jmnich/beam_kit_1/beam_kit_1.kicad_pcb

## KiCad design beam_kit_1.kicad_pcb (2026-11-06)

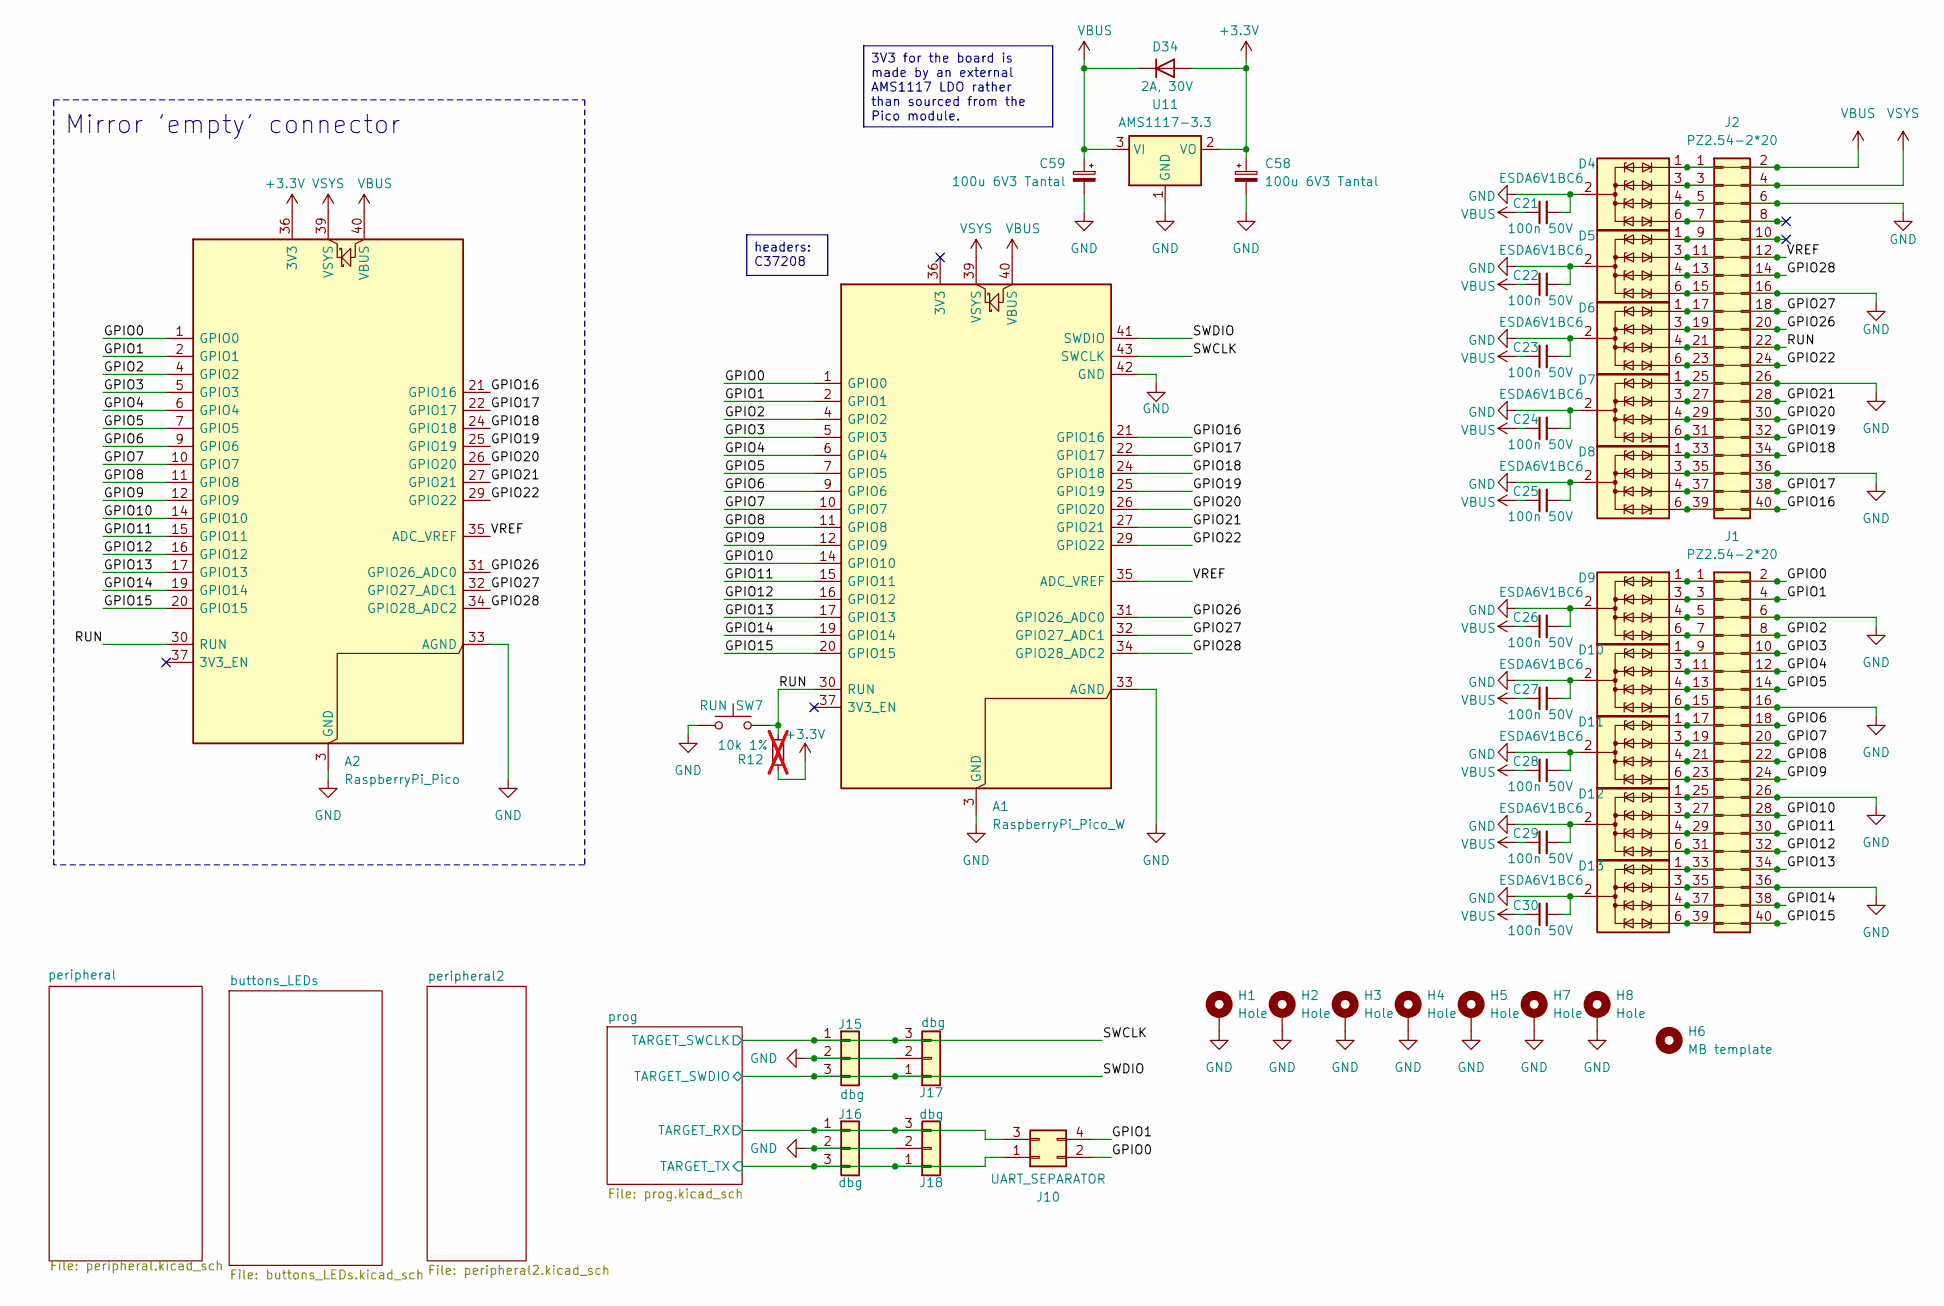
[picture p7: schematic beam_kit_1.kicad_sch]

Parts:
A1: RaspberryPi_Pico_W; RaspberryPi_Pico_Common
A2: RaspberryPi_Pico; RaspberryPi_Pico_Common
C21, C22, C23, C24, C25, C26, C27, C28, C29, C30: 100n 50V; C_0603_1608Metric_Pad1.08x0.95mm_HandSolder; jlc C14663
C58, C59: 100u 6V3 Tantal; CP_EIA-3528-21_Kemet-B_Pad1.50x2.35mm_HandSolder; jlc C16133
D4, D5, D6, D7, D8, D9, D10, D11, D12, D13: ESDA6V1BC6; SOT-23-6; MPN ESDA6V1BC6; jlc C495220
D34: 2A, 30V; D_PowerDI-123; MPN DFLS230LH-7; jlc C2960361
H1, H2, H3, H4, H5, H7, H8: Hole; MountingHole_3.2mm_M3_Pad_Via
H6: MB template; MountingHole_2.1mm
J1, J2: PZ2.54-2*20; PinHeader_2x20_P2.54mm_Vertical; jlc C5224014
J10: UART_SEPARATOR; PinHeader_2x02_P2.54mm_Vertical; jlc C7501273
J15, J16, J17, J18: dbg; JST_SH_BM03B-SRSS-TB_1x03-1MP_P1.00mm_Vertical; jlc C495538
R12: 10k 1%; R_0603_1608Metric_Pad0.98x0.95mm_HandSolder; jlc C25804; not fitted
SW7: RUN; SW_Push_1P1T_NO_6x6mm_H9.5mm; jlc C455112
U11: AMS1117-3.3; SOT-223-3_TabPin2; jlc C6186

Connections:
+3.3V: A2.36 (3V3), C58.1, D34.2 (A), R12.2, U11.2 (VO); also elsewhere on the board
/GPIO0: A1.1 (GPIO0), A2.1 (GPIO0), D9.1 (TVS1), J1.1, J1.2, J10.2
/GPIO1: A1.2 (GPIO1), A2.2 (GPIO1), D9.3 (TVS2), J1.3, J1.4, J10.4
/GPIO2: A1.4 (GPIO2), A2.4 (GPIO2), D9.6 (TVS4), J1.7, J1.8
/GPIO3: A1.5 (GPIO3), A2.5 (GPIO3), D10.1 (TVS1), J1.9, J1.10
/GPIO4: A1.6 (GPIO4), A2.6 (GPIO4), D10.3 (TVS2), J1.11, J1.12
/GPIO5: A1.7 (GPIO5), A2.7 (GPIO5), D10.4 (TVS3), J1.13, J1.14
/GPIO6: A1.9 (GPIO6), A2.9 (GPIO6), D11.1 (TVS1), J1.17, J1.18
/GPIO7: A1.10 (GPIO7), A2.10 (GPIO7), D11.3 (TVS2), J1.19, J1.20
/GPIO8: A1.11 (GPIO8), A2.11 (GPIO8), D11.4 (TVS3), J1.21, J1.22
/GPIO9: A1.12 (GPIO9), A2.12 (GPIO9), D11.6 (TVS4), J1.23, J1.24
/GPIO10: A1.14 (GPIO10), A2.14 (GPIO10), D12.3 (TVS2), J1.27, J1.28
/GPIO11: A1.15 (GPIO11), A2.15 (GPIO11), D12.4 (TVS3), J1.29, J1.30
/GPIO12: A1.16 (GPIO12), A2.16 (GPIO12), D12.6 (TVS4), J1.31, J1.32
/GPIO13: A1.17 (GPIO13), A2.17 (GPIO13), D13.1 (TVS1), J1.33, J1.34
/GPIO14: A1.19 (GPIO14), A2.19 (GPIO14), D13.4 (TVS3), J1.37, J1.38
/GPIO15: A1.20 (GPIO15), A2.20 (GPIO15), D13.6 (TVS4), J1.39, J1.40
/GPIO16: A1.21 (GPIO16), A2.21 (GPIO16), D8.6 (TVS4), J2.39, J2.40
/GPIO17: A1.22 (GPIO17), A2.22 (GPIO17), D8.4 (TVS3), J2.37, J2.38
/GPIO18: A1.24 (GPIO18), A2.24 (GPIO18), D8.1 (TVS1), J2.33, J2.34
/GPIO19: A1.25 (GPIO19), A2.25 (GPIO19), D7.6 (TVS4), J2.31, J2.32
/GPIO20: A1.26 (GPIO20), A2.26 (GPIO20), D7.4 (TVS3), J2.29, J2.30
/GPIO21: A1.27 (GPIO21), A2.27 (GPIO21), D7.3 (TVS2), J2.27, J2.28
/GPIO22: A1.29 (GPIO22), A2.29 (GPIO22), D6.6 (TVS4), J2.23, J2.24
/GPIO26: A1.31 (GPIO26_ADC0), A2.31 (GPIO26_ADC0), D6.3 (TVS2), J2.19, J2.20
/GPIO27: A1.32 (GPIO27_ADC1), A2.32 (GPIO27_ADC1), D6.1 (TVS1), J2.17, J2.18
/GPIO28: A1.34 (GPIO28_ADC2), A2.34 (GPIO28_ADC2), D5.4 (TVS3), J2.13, J2.14
/RUN: A1.30 (RUN), A2.30 (RUN), D6.4 (TVS3), J2.21, J2.22, R12.1, SW7.2
/SWCLK: A1.43 (SWCLK), J15.1, J17.3; also elsewhere on the board
/SWDIO: A1.41 (SWDIO), J15.3, J17.1; also elsewhere on the board
/VREF: A1.35 (ADC_VREF), A2.35 (ADC_VREF), D5.3 (TVS2), J2.11, J2.12
/prog/TARGET_RX: J10.3, J16.1, J18.3; also elsewhere on the board
/prog/TARGET_TX: J10.1, J16.3, J18.1; also elsewhere on the board
GND: A1.3 (GND), A1.8 (GND), A1.13 (GND), A1.18 (GND), A1.23 (GND), A1.28 (GND), A1.33 (AGND), A1.38 (GND), A1.42 (GND), A2.3 (GND), A2.8 (GND), A2.13 (GND), A2.18 (GND), A2.23 (GND), A2.28 (GND), A2.33 (AGND), A2.38 (GND), C21.2, C22.2, C23.2, C24.2, C25.2, C26.2, C27.2, C28.2, C29.2, C30.2, C58.2, C59.2, D4.2 (COM), D4.4 (TVS3), D4.5 (COM), D5.2 (COM), D5.5 (COM), D5.6 (TVS4), D6.2 (COM), D6.5 (COM), D7.1 (TVS1), D7.2 (COM), D7.5 (COM), D8.2 (COM), D8.3 (TVS2), D8.5 (COM), D9.2 (COM), D9.4 (TVS3), D9.5 (COM), D10.2 (COM), D10.5 (COM), D10.6 (TVS4), D11.2 (COM), D11.5 (COM), D12.1 (TVS1), D12.2 (COM), D12.5 (COM), D13.2 (COM), D13.3 (TVS2), D13.5 (COM), H1.1 (1_1), H2.1 (1_1), H3.1 (1_1), H4.1 (1_1), H5.1 (1_1), H7.1 (1_1), H8.1 (1_1), J1.5, J1.6, J1.15, J1.16, J1.25, J1.26, J1.35, J1.36, J2.5, J2.6, J2.15, J2.16, J2.25, J2.26, J2.35, J2.36, J15.2, J16.2, J17.2, J18.2, SW7.1, U11.1 (GND); also elsewhere on the board
VBUS: A1.40 (VBUS), A2.40 (VBUS), C21.1, C22.1, C23.1, C24.1, C25.1, C26.1, C27.1, C28.1, C29.1, C30.1, C59.1, D4.1 (TVS1), D34.1 (K), J2.1, J2.2, U11.3 (VI); also elsewhere on the board
VSYS: A1.39 (VSYS), A2.39 (VSYS), D4.3 (TVS2), J2.3, J2.4

Notes on the sheet:
Mirror 'empty' connector
3V3 for the board is made by an external AMS1117 LDO rather than sourced from the Pico module.
headers: C37208

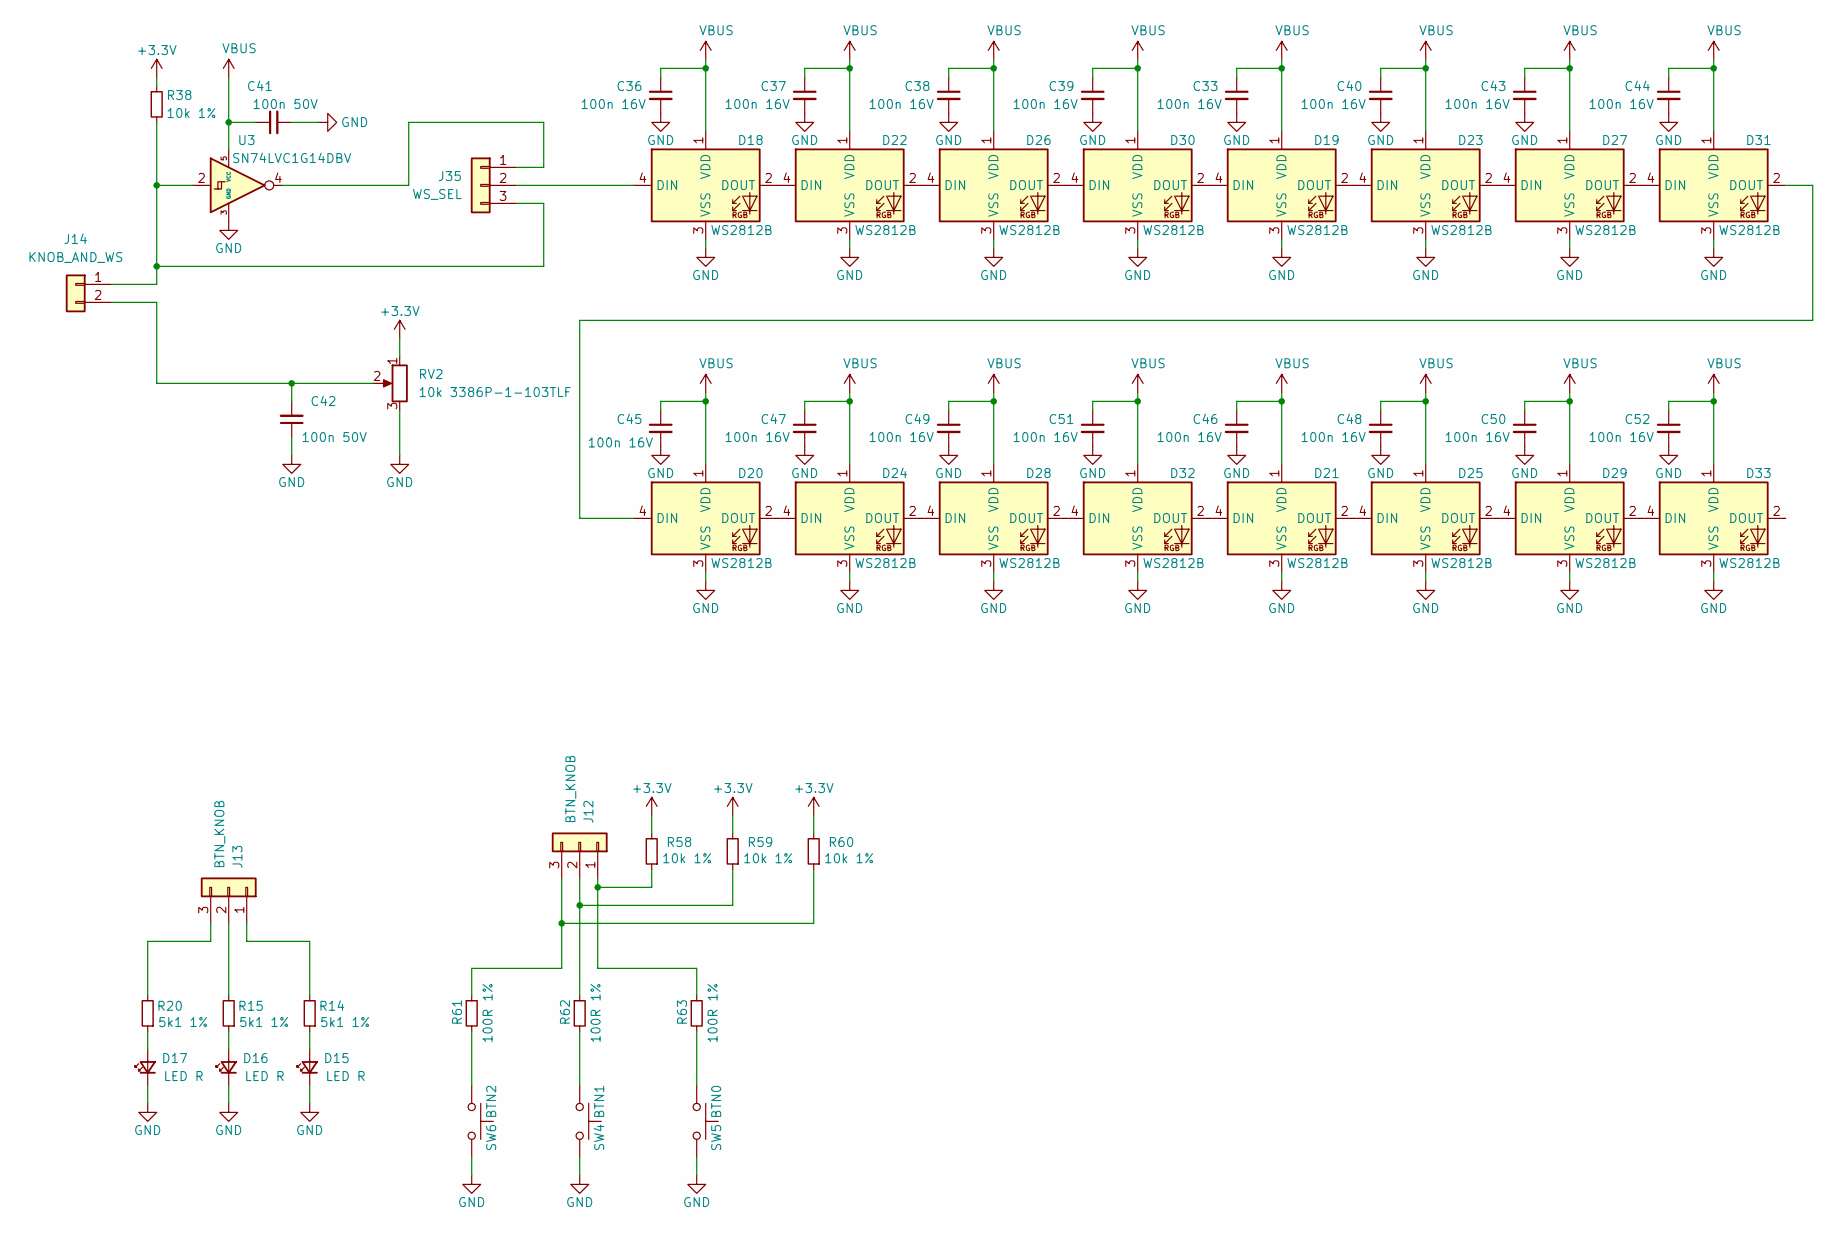
[picture p8: schematic buttons_LEDs.kicad_sch]

Parts:
C33, C36, C37, C38, C39, C40, C43, C44, C45, C46, C47, C48, C49, C50, C51, C52: 100n 16V; C_0402_1005Metric; MPN CL05B104KB54PNC; jlc C1525
C41, C42: 100n 50V; C_0603_1608Metric_Pad1.08x0.95mm_HandSolder; jlc C14663
D15, D16, D17: LED R; LED_0603_1608Metric_Pad1.05x0.95mm_HandSolder; jlc C2286
D18, D19, D20, D21, D22, D23, D24, D25, D26, D27, D28, D29, D30, D31, D32, D33: WS2812B; LED_WS2812B_PLCC4_5.0x5.0mm_P3.2mm; MPN XL-5050RGBC-WS2812B; jlc C2843785
J12, J13: BTN_KNOB; PinHeader_1x03_P2.54mm_Vertical; jlc C49257
J14: KNOB_AND_WS; PinHeader_1x02_P2.54mm_Vertical; jlc C492401
J35: WS_SEL; PinHeader_1x03_P2.54mm_Vertical; jlc C49257
R14, R15, R20: 5k1 1%; R_0603_1608Metric_Pad0.98x0.95mm_HandSolder; jlc C23186
R38, R58, R59, R60: 10k 1%; R_0603_1608Metric_Pad0.98x0.95mm_HandSolder; jlc C25804
R61, R62, R63: 100R 1%; R_0603_1608Metric_Pad0.98x0.95mm_HandSolder; jlc C22775
RV2: 10k 3386P-1-103TLF; Potentiometer_Bourns_3386P_Vertical; jlc C116302
SW4: BTN1; SW_Push_1P1T_NO_6x6mm_H9.5mm; jlc C455112
SW5: BTN0; SW_Push_1P1T_NO_6x6mm_H9.5mm; jlc C455112
SW6: BTN2; SW_Push_1P1T_NO_6x6mm_H9.5mm; jlc C455112
U3: SN74LVC1G14DBV; SOT-23-5; MPN SN74LVC1G14DBV; jlc C7835

Connections:
+3.3V: R38.1, R58.2, R59.2, R60.2, RV2.1; also elsewhere on the board
GND: C33.2, C36.2, C37.2, C38.2, C39.2, C40.2, C41.2, C42.1, C43.2, C44.2, C45.2, C46.2, C47.2, C48.2, C49.2, C50.2, C51.2, C52.2, D15.1 (K), D16.1 (K), D17.1 (K), D18.3 (VSS), D19.3 (VSS), D20.3 (VSS), D21.3 (VSS), D22.3 (VSS), D23.3 (VSS), D24.3 (VSS), D25.3 (VSS), D26.3 (VSS), D27.3 (VSS), D28.3 (VSS), D29.3 (VSS), D30.3 (VSS), D31.3 (VSS), D32.3 (VSS), D33.3 (VSS), RV2.3, SW4.2, SW5.2, SW6.2, U3.3 (GND); also elsewhere on the board
unnamed: D15.2 (A), R14.1
unnamed: D16.2 (A), R15.1
unnamed: D17.2 (A), R20.1
unnamed: D18.4 (DIN), J35.2
unnamed: D18.2 (DOUT), D22.4 (DIN)
unnamed: D19.4 (DIN), D30.2 (DOUT)
unnamed: D19.2 (DOUT), D23.4 (DIN)
unnamed: D20.4 (DIN), D31.2 (DOUT)
unnamed: D20.2 (DOUT), D24.4 (DIN)
unnamed: D21.4 (DIN), D32.2 (DOUT)
unnamed: D21.2 (DOUT), D25.4 (DIN)
unnamed: D22.2 (DOUT), D26.4 (DIN)
unnamed: D23.2 (DOUT), D27.4 (DIN)
unnamed: D24.2 (DOUT), D28.4 (DIN)
unnamed: D25.2 (DOUT), D29.4 (DIN)
unnamed: D26.2 (DOUT), D30.4 (DIN)
unnamed: D27.2 (DOUT), D31.4 (DIN)
unnamed: D28.2 (DOUT), D32.4 (DIN)
unnamed: D29.2 (DOUT), D33.4 (DIN)
unnamed: J12.1, R58.1, R63.1
unnamed: J12.2, R59.1, R62.1
unnamed: J12.3, R60.1, R61.1
unnamed: J13.1, R14.2
unnamed: J13.2, R15.2
unnamed: J13.3, R20.2
unnamed: J14.1, J35.3, R38.2, U3.2
unnamed: C42.2, J14.2, RV2.2
unnamed: J35.1, U3.4
unnamed: R61.2, SW6.1
unnamed: R62.2, SW4.1
unnamed: R63.2, SW5.1
VBUS: C33.1, C36.1, C37.1, C38.1, C39.1, C40.1, C41.1, C43.1, C44.1, C45.1, C46.1, C47.1, C48.1, C49.1, C50.1, C51.1, C52.1, D18.1 (VDD), D19.1 (VDD), D20.1 (VDD), D21.1 (VDD), D22.1 (VDD), D23.1 (VDD), D24.1 (VDD), D25.1 (VDD), D26.1 (VDD), D27.1 (VDD), D28.1 (VDD), D29.1 (VDD), D30.1 (VDD), D31.1 (VDD), D32.1 (VDD), D33.1 (VDD), U3.5 (VCC); also elsewhere on the board

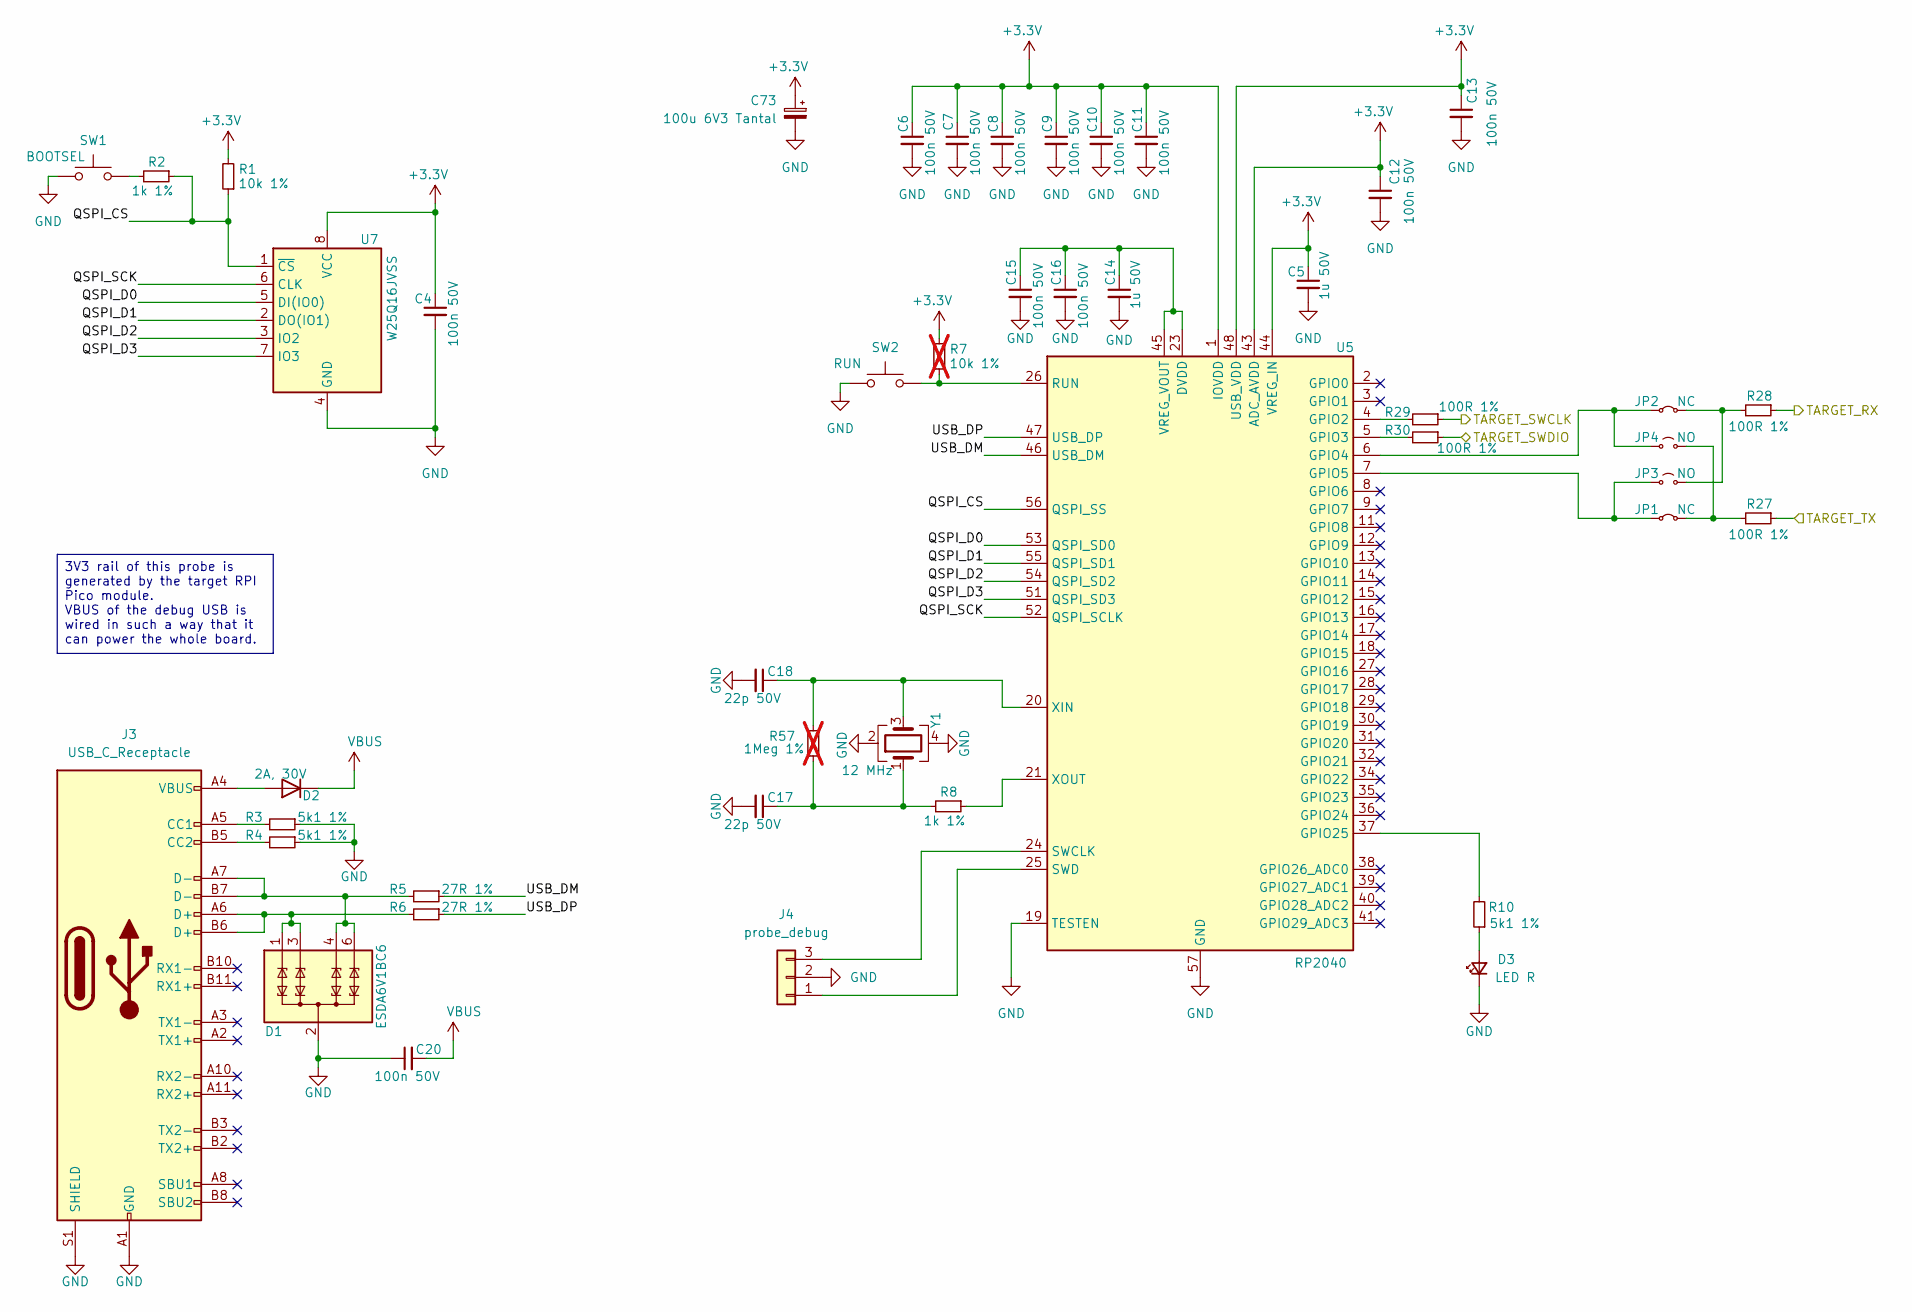
[picture p9: schematic prog.kicad_sch]

Parts:
C4, C6, C7, C8, C9, C10, C11, C12, C13, C15, C16, C20: 100n 50V; C_0603_1608Metric_Pad1.08x0.95mm_HandSolder; jlc C14663
C5, C14: 1u 50V; C_0603_1608Metric_Pad1.08x0.95mm_HandSolder; jlc C15849
C17, C18: 22p 50V; C_0603_1608Metric_Pad1.08x0.95mm_HandSolder; jlc C1653
C73: 100u 6V3 Tantal; CP_EIA-3528-21_Kemet-B_Pad1.50x2.35mm_HandSolder; jlc C16133
D1: ESDA6V1BC6; SOT-23-6; MPN ESDA6V1BC6; jlc C495220
D2: 2A, 30V; D_PowerDI-123; MPN DFLS230LH-7; jlc C2960361
D3: LED R; LED_0603_1608Metric_Pad1.05x0.95mm_HandSolder; jlc C2286
J3: USB_C_Receptacle; USB_C_Receptacle_Molex_105450-0101; jlc C134092
J4: probe_debug; PinHeader_1x03_P2.54mm_Vertical; jlc C49257
JP1, JP2: NC; SolderJumper-2_P1.3mm_Bridged_RoundedPad1.0x1.5mm
JP3, JP4: NO; SolderJumper-2_P1.3mm_Open_RoundedPad1.0x1.5mm
R1: 10k 1%; R_0603_1608Metric_Pad0.98x0.95mm_HandSolder; jlc C25804
R2, R8: 1k 1%; R_0603_1608Metric_Pad0.98x0.95mm_HandSolder; jlc C21190
R3, R4, R10: 5k1 1%; R_0603_1608Metric_Pad0.98x0.95mm_HandSolder; jlc C23186
R5, R6: 27R 1%; R_0603_1608Metric_Pad0.98x0.95mm_HandSolder; jlc C25190
R7: 10k 1%; R_0603_1608Metric_Pad0.98x0.95mm_HandSolder; jlc C25804; not fitted
R27, R28, R29, R30: 100R 1%; R_0603_1608Metric_Pad0.98x0.95mm_HandSolder; jlc C22775
R57: 1Meg 1%; R_0603_1608Metric_Pad0.98x0.95mm_HandSolder; not fitted
SW1: BOOTSEL; SW_SPST_B3U-1000P; jlc C231329
SW2: RUN; SW_SPST_B3U-1000P; jlc C231329
U5: RP2040; QFN-56-1EP_7x7mm_P0.4mm_EP3.2x3.2mm; jlc C2040
U7: W25Q16JVSS; SOIC-8_5.23x5.23mm_P1.27mm; jlc C131025
Y1: 12 MHz; Crystal_SMD_3225-4Pin_3.2x2.5mm; MPN X322512MSB4SI; jlc C9002

Connections:
+3.3V: C4.1, C5.1, C6.1, C7.1, C8.1, C9.1, C10.1, C11.1, C12.1, C13.1, C73.1, R1.2, R7.2, U5.1 (IOVDD), U5.10 (IOVDD), U5.22 (IOVDD), U5.33 (IOVDD), U5.42 (IOVDD), U5.43 (ADC_AVDD), U5.44 (VREG_IN), U5.48 (USB_VDD), U5.49 (IOVDD), U7.8 (VCC); also elsewhere on the board
/SWCLK: R29.1; also elsewhere on the board
/SWDIO: R30.1; also elsewhere on the board
/prog/QSPI_CS: R1.1, R2.1, U5.56 (QSPI_SS), U7.1 (~CS)
/prog/QSPI_D0: U5.53 (QSPI_SD0), U7.5 (DI(IO0))
/prog/QSPI_D1: U5.55 (QSPI_SD1), U7.2 (DO(IO1))
/prog/QSPI_D2: U5.54 (QSPI_SD2), U7.3 (IO2)
/prog/QSPI_D3: U5.51 (QSPI_SD3), U7.7 (IO3)
/prog/QSPI_SCK: U5.52 (QSPI_SCLK), U7.6 (CLK)
/prog/TARGET_RX: R28.1; also elsewhere on the board
/prog/TARGET_TX: R27.1; also elsewhere on the board
/prog/USB_DM: R5.1, U5.46 (USB_DM)
/prog/USB_DP: R6.1, U5.47 (USB_DP)
GND: C4.2, C5.2, C6.2, C7.2, C8.2, C9.2, C10.2, C11.2, C12.2, C13.2, C14.2, C15.2, C16.2, C17.2, C18.2, C20.1, C73.2, D1.2 (COM), D1.5 (COM), D3.1 (K), J3.A1 (GND), J3.A12 (GND), J3.B1 (GND), J3.B12 (GND), J3.S1 (SHIELD), J4.2, R3.1, R4.1, SW1.1, SW2.1, U5.19 (TESTEN), U5.57 (GND), U7.4 (GND), Y1.2, Y1.4; also elsewhere on the board
unnamed: C17.1, R8.2, R57.2, Y1.1
unnamed: D1.1 (TVS1), D1.3 (TVS2), J3.A6 (D+), J3.B6 (D+), R6.2
unnamed: D1.4 (TVS3), D1.6 (TVS4), J3.A7 (D-), J3.B7 (D-), R5.2
unnamed: D2.2 (A), J3.A4 (VBUS), J3.A9 (VBUS), J3.B4 (VBUS), J3.B9 (VBUS)
unnamed: D3.2 (A), R10.1
unnamed: J3.A5 (CC1), R3.2
unnamed: J3.B5 (CC2), R4.2
unnamed: J4.1, U5.25 (SWD)
unnamed: J4.3, U5.24 (SWCLK)
unnamed: JP1.1 (A), JP3.1 (A), U5.7 (GPIO5)
unnamed: JP1.2 (B), JP4.2 (B), R27.2
unnamed: JP2.1 (A), JP4.1 (A), U5.6 (GPIO4)
unnamed: JP2.2 (B), JP3.2 (B), R28.2
unnamed: R2.2, SW1.2
unnamed: R29.2, U5.4 (GPIO2)
unnamed: R30.2, U5.5 (GPIO3)
unnamed: R10.2, U5.37 (GPIO25)
unnamed: R7.1, SW2.2, U5.26 (RUN)
unnamed: C14.1, C15.1, C16.1, U5.23 (DVDD), U5.45 (VREG_VOUT), U5.50 (DVDD)
unnamed: C18.1, R57.1, U5.20 (XIN), Y1.3
unnamed: R8.1, U5.21 (XOUT)
VBUS: C20.2, D2.1 (K); also elsewhere on the board

Notes on the sheet:
3V3 rail of this probe is generated by the target RPI Pico module. VBUS of the debug USB is wired in such a way that it can power the whole board.

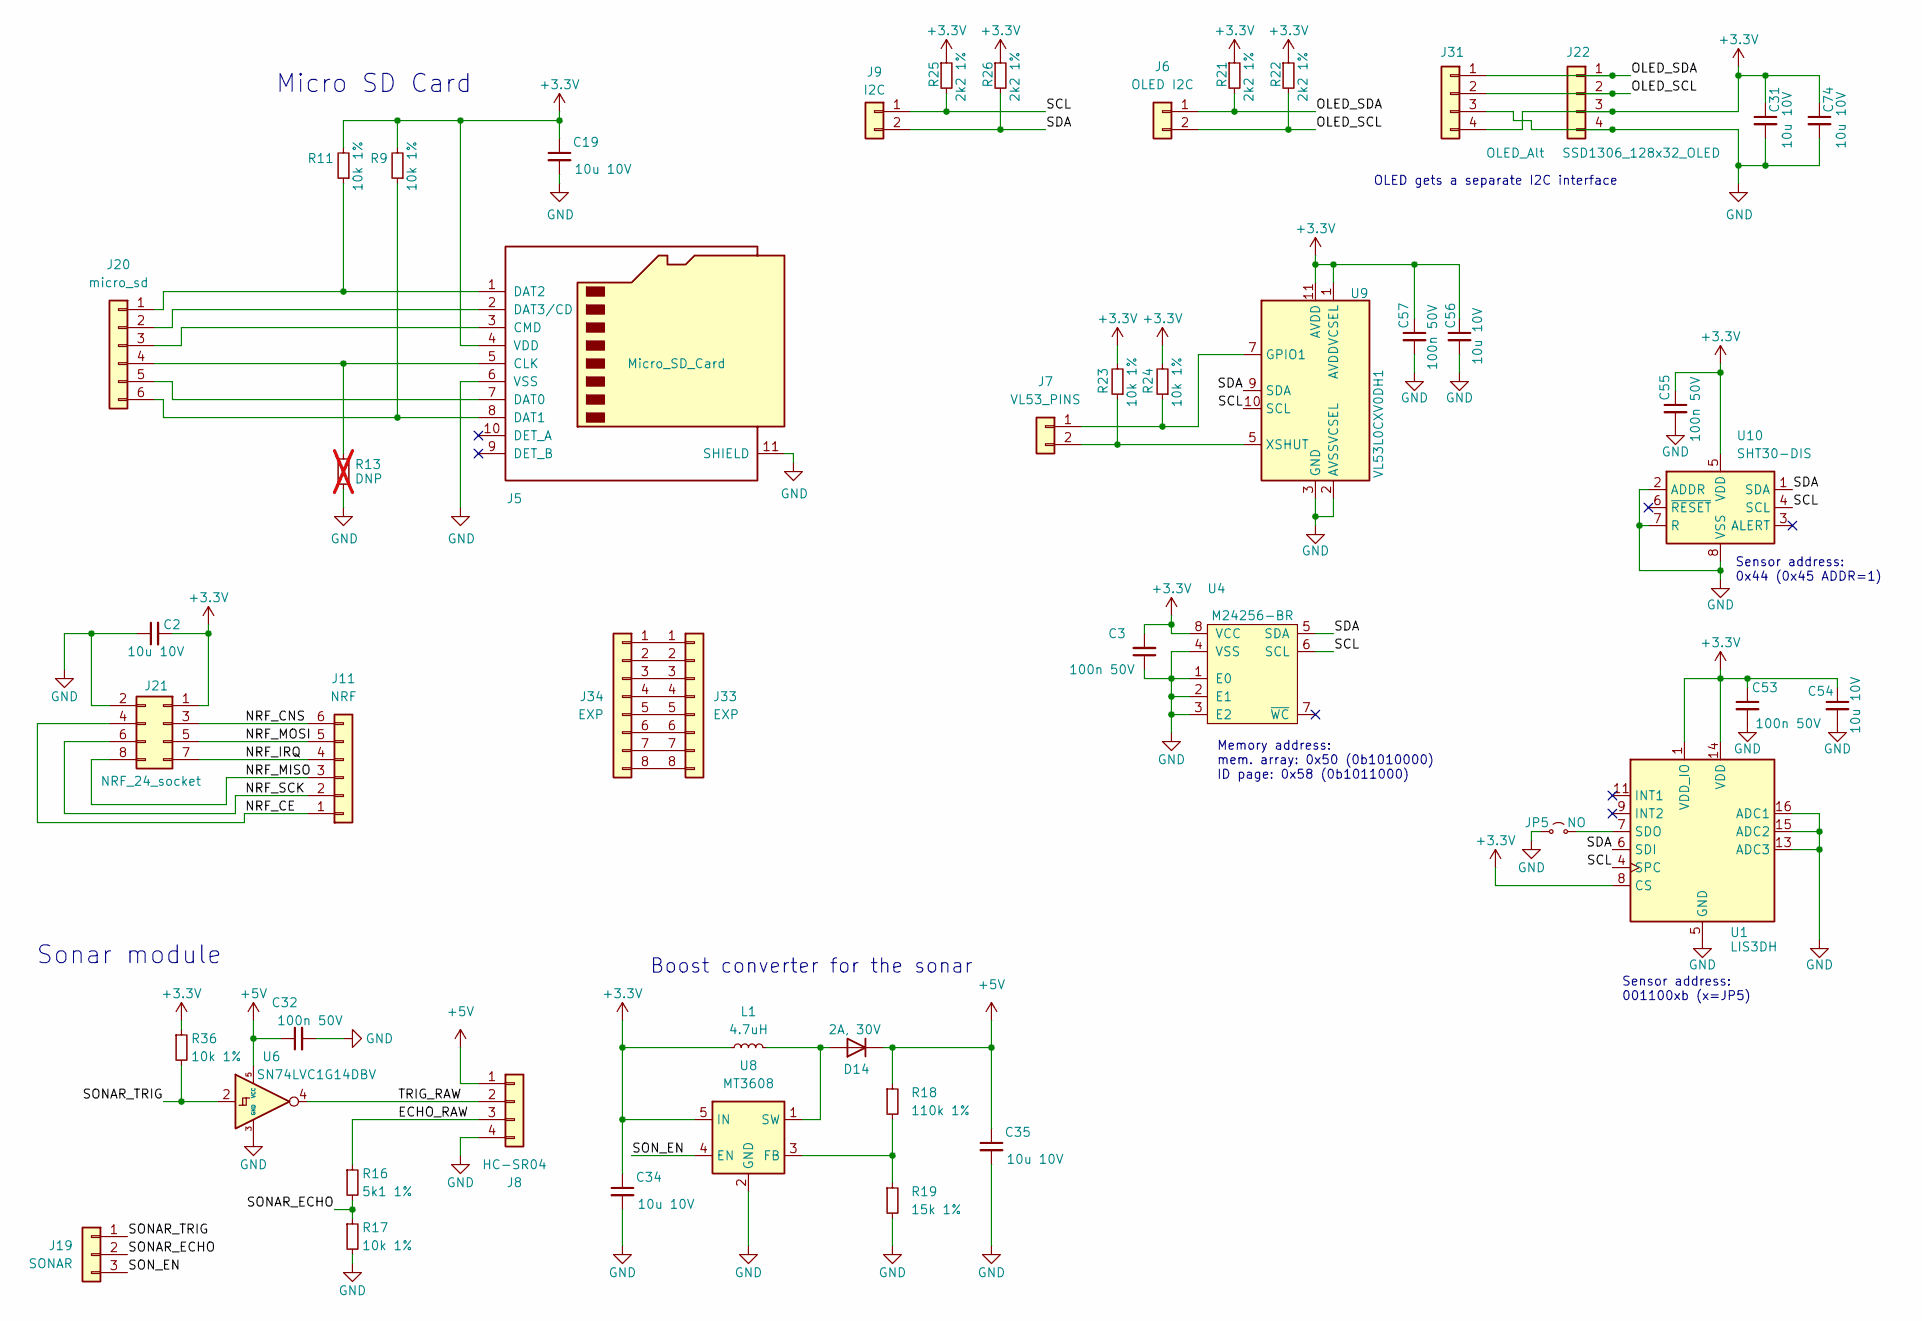
[picture p10: schematic peripheral.kicad_sch]

Parts:
C2, C19, C31, C34, C35, C54, C56, C74: 10u 10V; C_0603_1608Metric_Pad1.08x0.95mm_HandSolder; jlc C19702
C3, C32, C53, C55, C57: 100n 50V; C_0603_1608Metric_Pad1.08x0.95mm_HandSolder; jlc C14663
D14: 2A, 30V; D_PowerDI-123; MPN DFLS230LH-7; jlc C2960361
J5: Micro_SD_Card; microSD_HC_Molex_104031-0811; jlc C585350
J6: OLED I2C; PinHeader_1x02_P2.54mm_Vertical; jlc C492401
J7: VL53_PINS; PinHeader_1x02_P2.54mm_Vertical; jlc C492401
J8: HC-SR04; PinSocket_1x04_P2.54mm_Vertical; jlc C2718488
J9: I2C; PinHeader_1x02_P2.54mm_Vertical; jlc C492401
J11: NRF; PinHeader_1x06_P2.54mm_Vertical; jlc C37208
J19: SONAR; PinHeader_1x03_P2.54mm_Vertical; jlc C49257
J20: micro_sd; PinHeader_1x06_P2.54mm_Vertical; jlc C37208
J21: NRF_24_socket; PinSocket_2x04_P2.54mm_Vertical; jlc C92271
J22: SSD1306_128x32_OLED; PinSocket_1x04_P2.54mm_Vertical; jlc C2718488
J31: OLED_Alt; PinSocket_1x04_P2.54mm_Vertical; jlc C2718488
J33: EXP; PinHeader_1x08_P2.54mm_Vertical; jlc C18078205
J34: EXP; PinSocket_1x08_P2.54mm_Vertical; jlc C5224027
JP5: NO; SolderJumper-2_P1.3mm_Open_RoundedPad1.0x1.5mm
L1: 4.7uH; L_1206_3216Metric_Pad1.22x1.90mm_HandSolder; MPN CMP321609UD4R7MT; jlc C139250
R9, R11, R17, R23, R24, R36: 10k 1%; R_0603_1608Metric_Pad0.98x0.95mm_HandSolder; jlc C25804
R13: DNP; R_0603_1608Metric_Pad0.98x0.95mm_HandSolder; not fitted
R16: 5k1 1%; R_0603_1608Metric_Pad0.98x0.95mm_HandSolder; jlc C23186
R18: 110k 1%; R_0603_1608Metric_Pad0.98x0.95mm_HandSolder; jlc C25805
R19: 15k 1%; R_0603_1608Metric_Pad0.98x0.95mm_HandSolder; jlc C22809
R21, R22, R25, R26: 2k2 1%; R_0603_1608Metric_Pad0.98x0.95mm_HandSolder; jlc C4190
U1: LIS3DH; LGA-16_3x3mm_P0.5mm_LayoutBorder3x5y; jlc C15134
U4: M24256-BR; SOIC-8_3.9x4.9mm_P1.27mm; MPN M24256-BRMN6TP; jlc C79984
U6: SN74LVC1G14DBV; SOT-23-5; MPN SN74LVC1G14DBV; jlc C7835
U8: MT3608; SOT-23-6; jlc C84817
U9: VL53L0CXV0DH1; ST_VL53L1x; jlc C91199
U10: SHT30-DIS; Sensirion_DFN-8-1EP_2.5x2.5mm_P0.5mm_EP1.1x1.7mm; jlc C2687423

Connections:
+3.3V: C2.2, C3.2, C19.1, C31.1, C34.1, C53.1, C54.1, C55.1, C56.1, C57.1, C74.1, J5.4 (VDD), J21.1, J22.3, J31.4, L1.1, R9.2, R11.2, R21.1, R22.1, R23.2, R24.2, R25.1, R26.1, R36.1, U1.1 (VDD_IO), U1.8 (CS), U1.14 (VDD), U4.8 (VCC), U8.5 (IN), U9.1 (AVDDVCSEL), U9.11 (AVDD), U10.5 (VDD); also elsewhere on the board
+5V: C32.1, C35.1, D14.1 (K), J8.1, R18.1, U6.5 (VCC)
/peripheral/ECHO_RAW: J8.3, R16.1
/peripheral/NRF_CE: J11.1, J21.4
/peripheral/NRF_CNS: J11.6, J21.3
/peripheral/NRF_IRQ: J11.4, J21.7
/peripheral/NRF_MISO: J11.3, J21.8
/peripheral/NRF_MOSI: J11.5, J21.5
/peripheral/NRF_SCK: J11.2, J21.6
/peripheral/OLED_SCL: J6.2, J22.2, J31.2, R22.2
/peripheral/OLED_SDA: J6.1, J22.1, J31.1, R21.2
/peripheral/SCL: J9.1, R25.2, U1.4 (SPC), U4.6 (SCL), U9.10 (SCL), U10.4 (SCL)
/peripheral/SDA: J9.2, R26.2, U1.6 (SDI), U4.5 (SDA), U9.9 (SDA), U10.1 (SDA)
/peripheral/SONAR_ECHO: J19.2, R16.2, R17.1
/peripheral/SONAR_TRIG: J19.1, R36.2, U6.2
/peripheral/SON_EN: J19.3, U8.4 (EN)
/peripheral/TRIG_RAW: J8.2, U6.4
GND: C2.1, C3.1, C19.2, C31.2, C32.2, C34.2, C35.2, C53.2, C54.2, C55.2, C56.2, C57.2, C74.2, J5.6 (VSS), J5.11 (SHIELD), J8.4, J21.2, J22.4, J31.3, JP5.1 (A), R13.2, R17.2, R19.2, U1.5 (GND), U1.10 (GND), U1.12 (GND), U1.13 (ADC3), U1.15 (ADC2), U1.16 (ADC1), U4.1 (E0), U4.2 (E1), U4.3 (E2), U4.4 (VSS), U6.3 (GND), U8.2 (GND), U9.2 (AVSSVCSEL), U9.3 (GND), U9.4 (GND), U9.6 (GND), U9.12 (GND), U10.2 (ADDR), U10.7 (R), U10.8 (VSS), U10.9 (VSS); also elsewhere on the board
unnamed: D14.2 (A), L1.2, U8.1 (SW)
unnamed: J7.1, R24.1, U9.7 (GPIO1)
unnamed: J7.2, R23.1, U9.5 (XSHUT)
unnamed: J5.1 (DAT2), J20.1, R11.1
unnamed: J5.2 (DAT3/CD), J20.2
unnamed: J5.3 (CMD), J20.3
unnamed: J5.5 (CLK), J20.4, R13.1
unnamed: J5.7 (DAT0), J20.5
unnamed: J5.8 (DAT1), J20.6, R9.1
unnamed: J33.1, J34.1
unnamed: J33.2, J34.2
unnamed: J33.3, J34.3
unnamed: J33.4, J34.4
unnamed: J33.5, J34.5
unnamed: J33.6, J34.6
unnamed: J33.7, J34.7
unnamed: J33.8, J34.8
unnamed: JP5.2 (B), U1.7 (SDO)
unnamed: R18.2, R19.1, U8.3 (FB)

Notes on the sheet:
Micro SD Card
Boost converter for the sonar
Memory address: mem. array: 0x50 (0b1010000) ID page: 0x58 (0b1011000)
Sensor address: 0x44 (0x45 ADDR=1)
Sonar module
Sensor address: 001100xb (x=JP5)
OLED gets a separate I2C interface
