jmnich/beam_kit_1/beam_kit_1.kicad_pcb

## KiCad design beam_kit_1.kicad_pcb (continued)

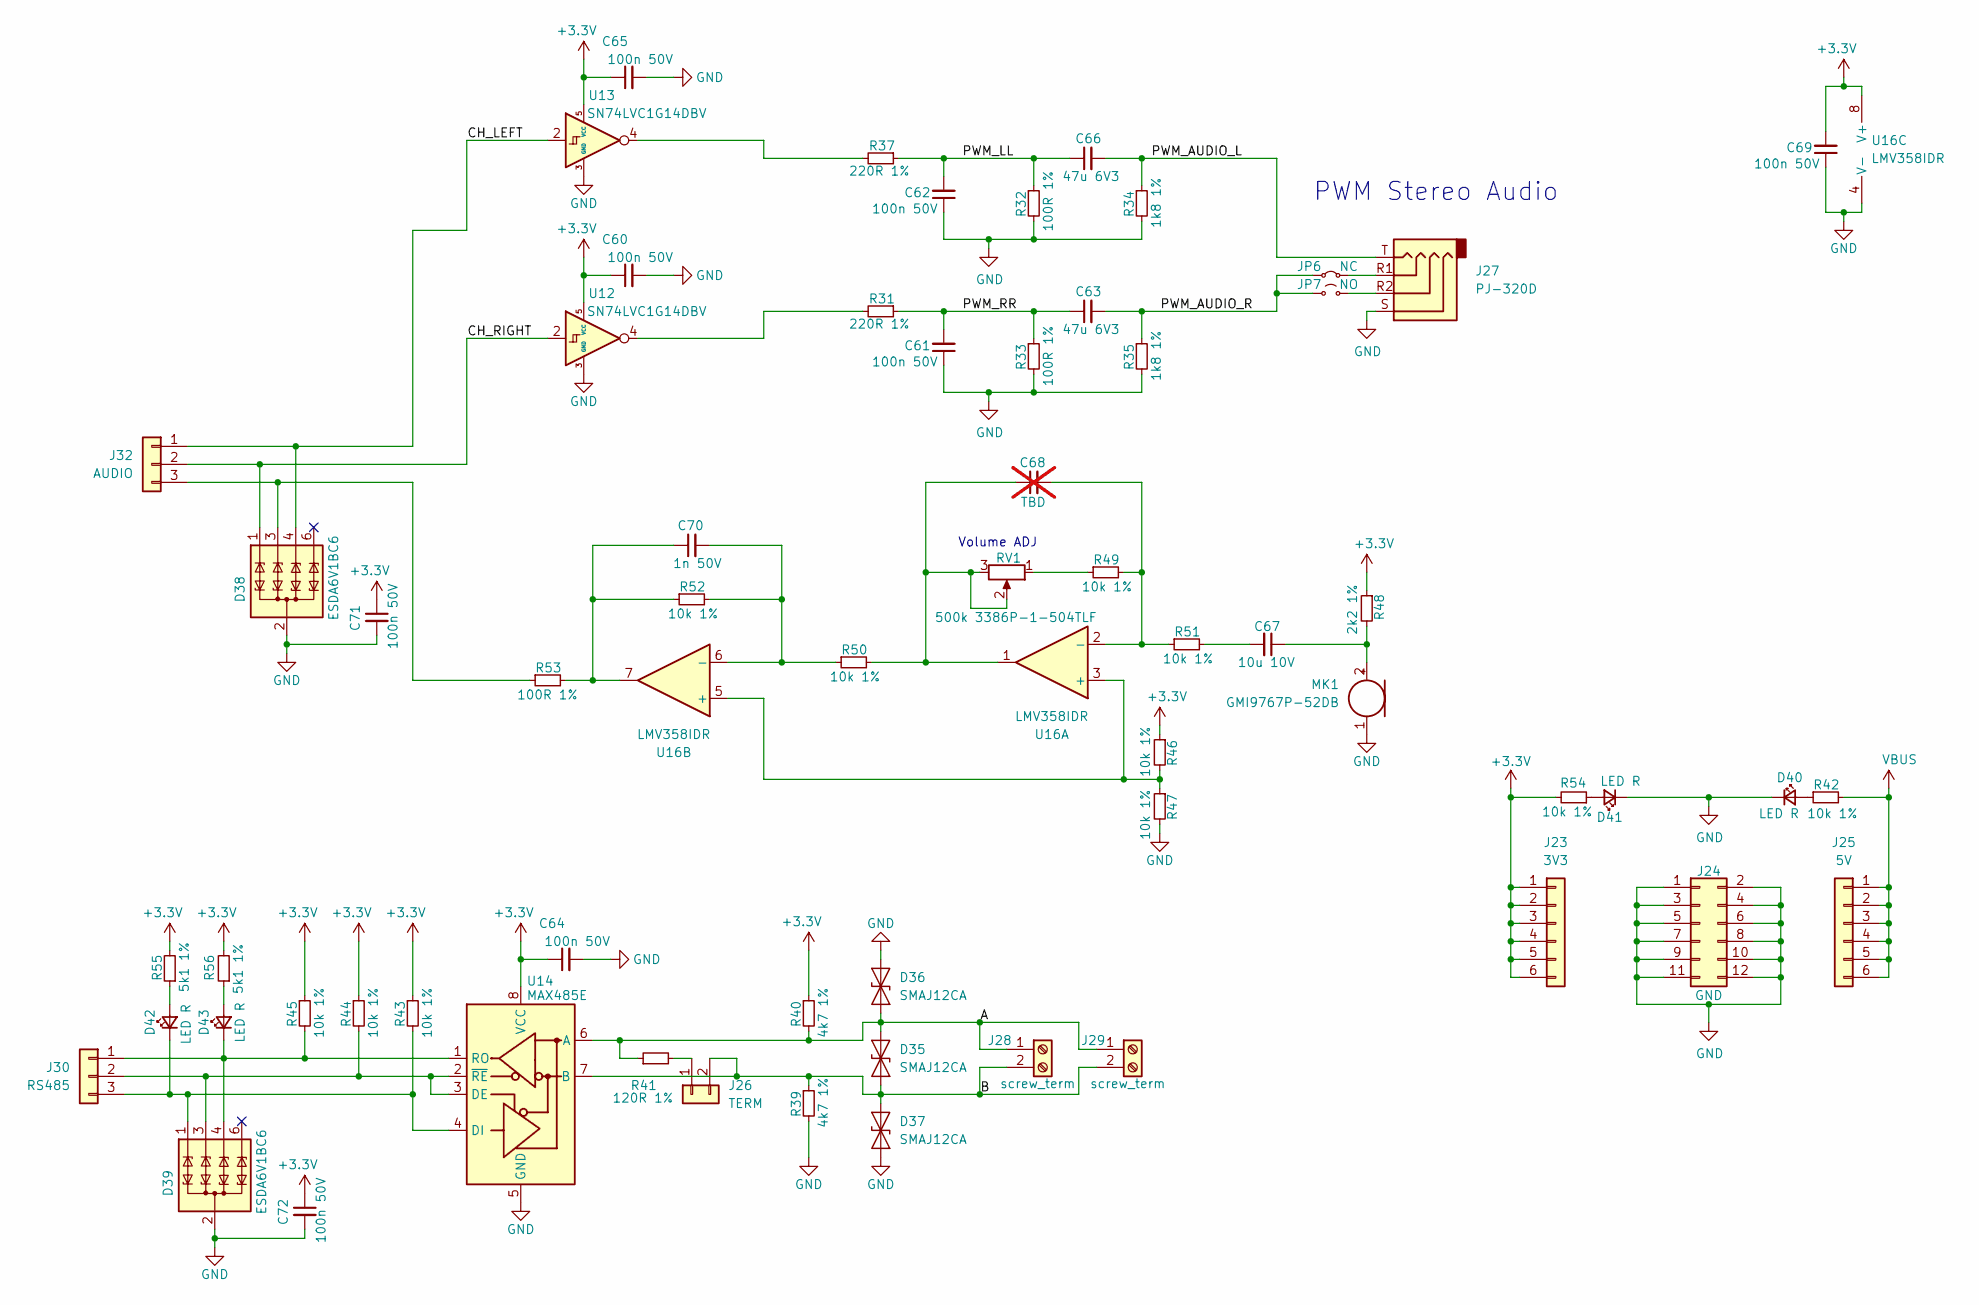
[picture p11: schematic peripheral2.kicad_sch]

Parts:
C60, C61, C62, C64, C65, C69, C71, C72: 100n 50V; C_0603_1608Metric_Pad1.08x0.95mm_HandSolder; jlc C14663
C63, C66: 47u 6V3; C_0805_2012Metric; jlc C16780
C67: 10u 10V; C_0603_1608Metric_Pad1.08x0.95mm_HandSolder; jlc C19702
C68: TBD; C_0603_1608Metric_Pad1.08x0.95mm_HandSolder; not fitted
C70: 1n 50V; C_0603_1608Metric_Pad1.08x0.95mm_HandSolder; jlc C1588
D35, D36, D37: SMAJ12CA; D_SMA; jlc C908818
D38, D39: ESDA6V1BC6; SOT-23-6; MPN ESDA6V1BC6; jlc C495220
D40, D41, D42, D43: LED R; LED_0603_1608Metric_Pad1.05x0.95mm_HandSolder; jlc C2286
J23: 3V3; PinHeader_1x06_P2.54mm_Vertical; jlc C37208
J24: GND; PinHeader_2x06_P2.54mm_Vertical; jlc C492423
J25: 5V; PinHeader_1x06_P2.54mm_Vertical; jlc C37208
J26: TERM; PinHeader_1x02_P2.54mm_Vertical; jlc C492401
J27: PJ-320D; Jack_3.5mm_PJ320D_Horizontal; jlc C431535
J28, J29: screw_term; TerminalBlock_Phoenix_MKDS-1,5-2-5.08_1x02_P5.08mm_Horizont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; jlc C395734
J30: RS485; PinHeader_1x03_P2.54mm_Vertical; jlc C49257
J32: AUDIO; PinHeader_1x03_P2.54mm_Vertical; jlc C49257
JP6: NC; SolderJumper-2_P1.3mm_Bridged_RoundedPad1.0x1.5mm
JP7: NO; SolderJumper-2_P1.3mm_Open_RoundedPad1.0x1.5mm
MK1: GMI9767P-52DB; PinHeader_1x02_P2.54mm_Vertical; jlc C234023
R31, R37: 220R 1%; R_0603_1608Metric_Pad0.98x0.95mm_HandSolder; jlc C22962
R32, R33, R53: 100R 1%; R_0603_1608Metric_Pad0.98x0.95mm_HandSolder; jlc C22775
R34, R35: 1k8 1%; R_0603_1608Metric_Pad0.98x0.95mm_HandSolder; jlc C4177
R39, R40: 4k7 1%; R_0603_1608Metric_Pad0.98x0.95mm_HandSolder; jlc C23162
R41: 120R 1%; R_0603_1608Metric_Pad0.98x0.95mm_HandSolder; jlc C22787
R42, R43, R44, R45, R46, R47, R49, R50, R51, R52, R54: 10k 1%; R_0603_1608Metric_Pad0.98x0.95mm_HandSolder; jlc C25804
R48: 2k2 1%; R_0603_1608Metric_Pad0.98x0.95mm_HandSolder; jlc C4190
R55, R56: 5k1 1%; R_0603_1608Metric_Pad0.98x0.95mm_HandSolder; jlc C23186
RV1: 500k 3386P-1-504TLF; Potentiometer_Bourns_3386P_Vertical; jlc C116316
U12, U13: SN74LVC1G14DBV; SOT-23-5; MPN SN74LVC1G14DBV; jlc C7835
U14: MAX485E; SOIC-8_3.9x4.9mm_P1.27mm; jlc C19738
U16: LMV358IDR; SOIC-8_3.9x4.9mm_P1.27mm; jlc C63813

Connections:
+3.3V: C60.1, C64.1, C65.1, C69.2, C71.1, C72.1, J23.1, J23.2, J23.3, J23.4, J23.5, J23.6, R40.1, R43.1, R44.1, R45.1, R46.1, R48.1, R54.2, R55.2, R56.2, U12.5 (VCC), U13.5 (VCC), U14.8 (VCC), U16.8 (V+); also elsewhere on the board
/peripheral2/A: D35.2 (A2), D36.1 (A1), J28.1, J29.1, R40.2, R41.1, U14.6 (A)
/peripheral2/B: D35.1 (A1), D37.2 (A2), J26.2, J28.2, J29.2, R39.1, U14.7 (B)
/peripheral2/CH_LEFT: D38.4 (TVS3), J32.1, U13.2
/peripheral2/CH_RIGHT: D38.1 (TVS1), J32.2, U12.2
/peripheral2/PWM_AUDIO_L: C66.2, J27.T, R34.1
/peripheral2/PWM_AUDIO_R: C63.2, JP6.1 (A), JP7.1 (A), R35.1
/peripheral2/PWM_LL: C62.2, C66.1, R32.1, R37.1
/peripheral2/PWM_RR: C61.2, C63.1, R31.1, R33.1
GND: C60.2, C61.1, C62.1, C64.2, C65.2, C69.1, C71.2, C72.2, D36.2 (A2), D37.1 (A1), D38.2 (COM), D38.5 (COM), D39.2 (COM), D39.5 (COM), D40.1 (K), D41.1 (K), J24.1, J24.2, J24.3, J24.4, J24.5, J24.6, J24.7, J24.8, J24.9, J24.10, J24.11, J24.12, J27.S, MK1.1 (-), R32.2, R33.2, R34.2, R35.2, R39.2, R47.2, U12.3 (GND), U13.3 (GND), U14.5 (GND), U16.4 (V-); also elsewhere on the board
unnamed: C67.2, R51.2
unnamed: C68.1, R50.2, RV1.2, RV1.3, U16.1
unnamed: C70.1, R52.1, R53.2, U16.7
unnamed: D38.3 (TVS2), J32.3, R53.1
unnamed: D39.1 (TVS1), D42.1 (K), J30.3, R43.2, U14.4 (DI)
unnamed: D39.3 (TVS2), J30.2, R44.2, U14.2 (~RE), U14.3 (DE)
unnamed: D39.4 (TVS3), D43.1 (K), J30.1, R45.2, U14.1 (RO)
unnamed: D40.2 (A), R42.1
unnamed: D41.2 (A), R54.1
unnamed: D42.2 (A), R55.1
unnamed: D43.2 (A), R56.1
unnamed: J26.1, R41.2
unnamed: J27.R1, JP6.2 (B)
unnamed: J27.R2, JP7.2 (B)
unnamed: C67.1, MK1.2 (+), R48.2
unnamed: R31.2, U12.4
unnamed: R37.2, U13.4
unnamed: R49.1, RV1.1
unnamed: R46.2, R47.1, U16.3 (+), U16.5 (+)
unnamed: C68.2, R49.2, R51.1, U16.2 (-)
unnamed: C70.2, R50.1, R52.2, U16.6 (-)
VBUS: J25.1, J25.2, J25.3, J25.4, J25.5, J25.6, R42.2; also elsewhere on the board

Notes on the sheet:
PWM Stereo Audio
Volume ADJ

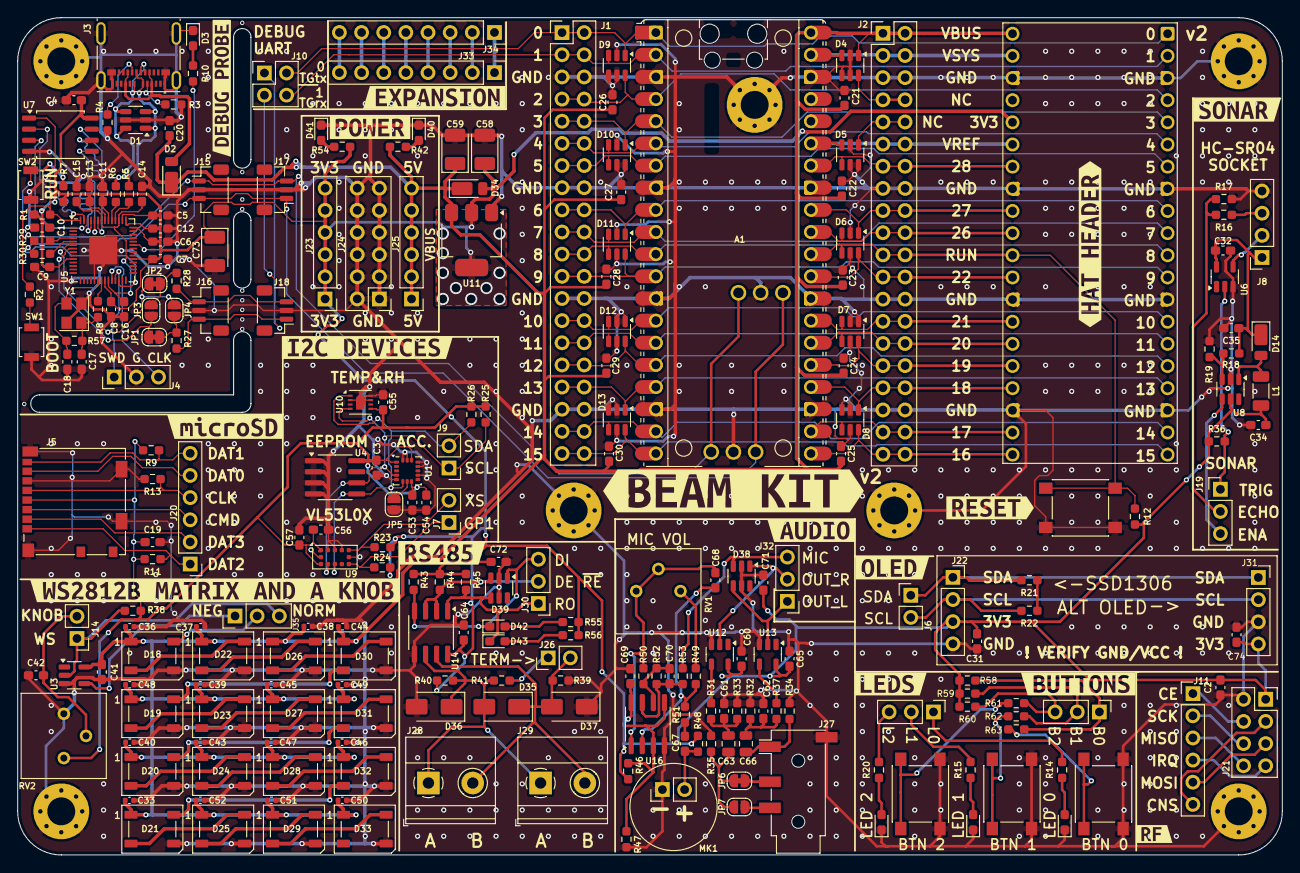
[picture p12: board beam_kit_1.kicad_pcb from above]

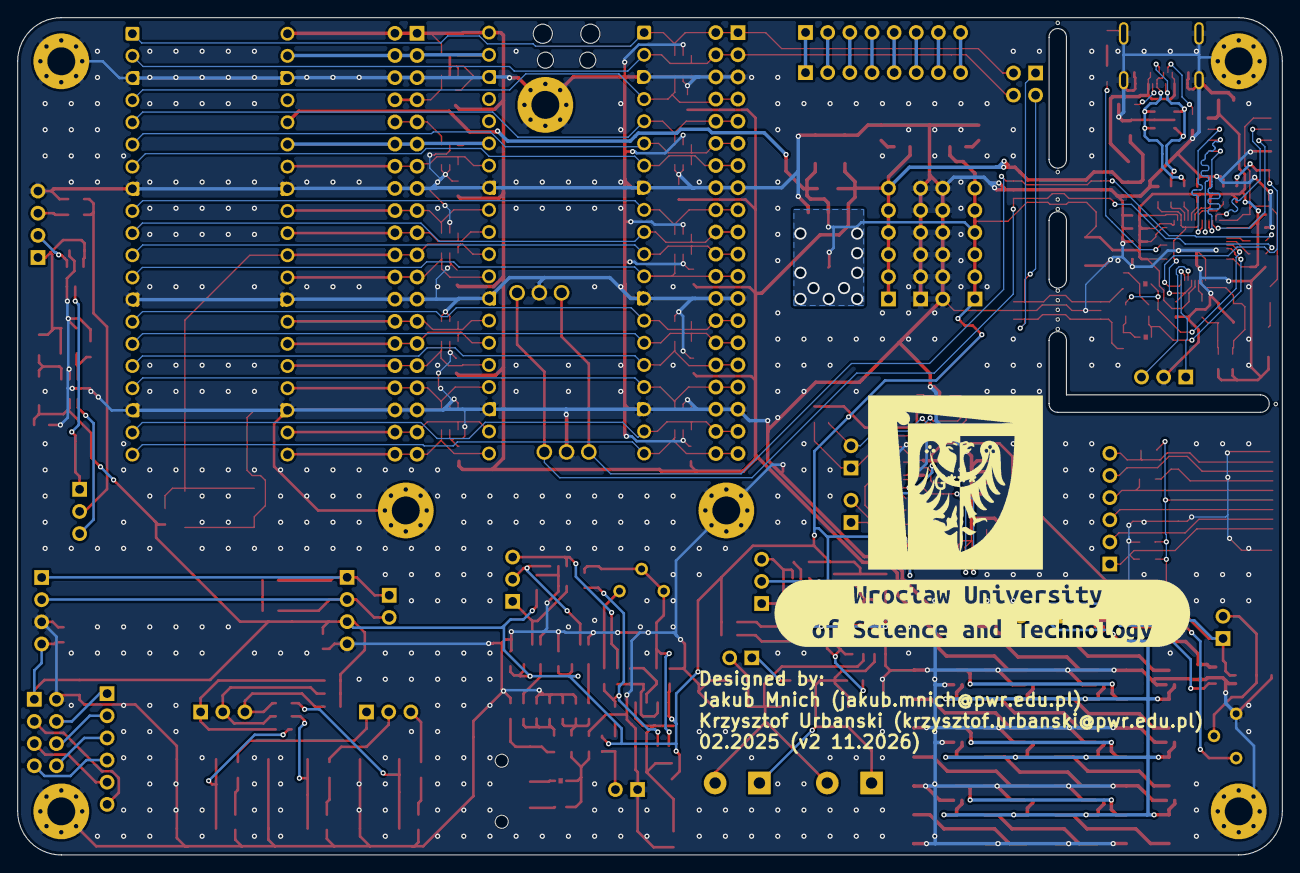
[picture p13: board beam_kit_1.kicad_pcb from below]

Board: 2 copper layers, 145.0 x 96.0 mm, 282 parts (2 on the bottom side), 160 nets.

Other parts of the board:
H6#2, H6#3, H6#4, H6#5, H6#6, H6#7, H6#8, H6#9, H6#10: MB template; MountingHole_2.1mm
kibuzzard-6AEDD45B: G***; kibuzzard-6AEDD45B
kibuzzard-62ECE595: G***; kibuzzard-62ECE595
kibuzzard-67BB2A6B: G***; kibuzzard-67BB2A6B
kibuzzard-67BB2A29: G***; kibuzzard-67BB2A29
kibuzzard-67BB2BB0: G***; kibuzzard-67BB2BB0
kibuzzard-67BB2C58: G***; kibuzzard-67BB2C58
kibuzzard-67BB2CB4: G***; kibuzzard-67BB2CB4
kibuzzard-67BB2CE4: G***; kibuzzard-67BB2CE4
kibuzzard-67BB2D55: G***; kibuzzard-67BB2D55
kibuzzard-67BB2DE0: G***; kibuzzard-67BB2DE0
kibuzzard-67BB2F8C: G***; kibuzzard-67BB2F8C
kibuzzard-67BB2FFD: G***; kibuzzard-67BB2FFD
kibuzzard-67BB3BA0: G***; kibuzzard-67BB3BA0
kibuzzard-67BB3D27: G***; kibuzzard-67BB3D27
kibuzzard-67BB581A: G***; kibuzzard-67BB581A
kibuzzard-67BB3747: G***; kibuzzard-67BB3747
kibuzzard-67BB4182: G***; kibuzzard-67BB4182
