jmnich/beam_kit_1/(commit log)

2025-02-22 fit test
    [beam_kit_1.kicad_pcb, beam_kit_1.kicad_sch, peripheral.kicad_sch, prog.kicad_sch]
2025-02-23 preparing for more modules
    [beam_kit_1.kicad_pcb, beam_kit_1.kicad_sch, peripheral.kicad_sch]
2025-02-23 more stuff added to sch
    [beam_kit_1.kicad_pcb, beam_kit_1.kicad_sch, buttons_LEDs.kicad_sch, peripheral.kicad_sch, peripheral2.kicad_sch, prog.kicad_sch]
2025-02-23 kju fix and PCB size increase
    [beam_kit_1.kicad_pcb, beam_kit_1.kicad_sch, buttons_LEDs.kicad_sch, peripheral.kicad_sch, peripheral2.kicad_sch]
2025-02-23 layout done
    [beam_kit_1.kicad_pcb, peripheral.kicad_sch, peripheral2.kicad_sch]
2025-02-23 codes and fixes
    [beam_kit_1.kicad_pcb, beam_kit_1.kicad_sch, buttons_LEDs.kicad_sch, peripheral.kicad_sch, peripheral2.kicad_sch, prog.kicad_sch]
2025-02-23 RS leds fix
    [beam_kit_1.kicad_pcb, peripheral2.kicad_sch]
2025-02-23 jlc codes filled
    [beam_kit_1.kicad_pcb, beam_kit_1.kicad_sch, buttons_LEDs.kicad_sch, peripheral.kicad_sch, peripheral2.kicad_sch, prog.kicad_sch]
2025-02-23 routing in progress
    [beam_kit_1.kicad_pcb, beam_kit_1.kicad_sch, buttons_LEDs.kicad_sch, prog.kicad_sch]
2025-02-24 final version
    [beam_kit_1.kicad_pcb, beam_kit_1.kicad_sch, buttons_LEDs.kicad_sch, peripheral.kicad_sch, peripheral2.kicad_sch, prog.kicad_sch]
2026-11-05 larger rst button
